ray4477/Senior-design-fit-ml/3D_enclosure/case v1.stl

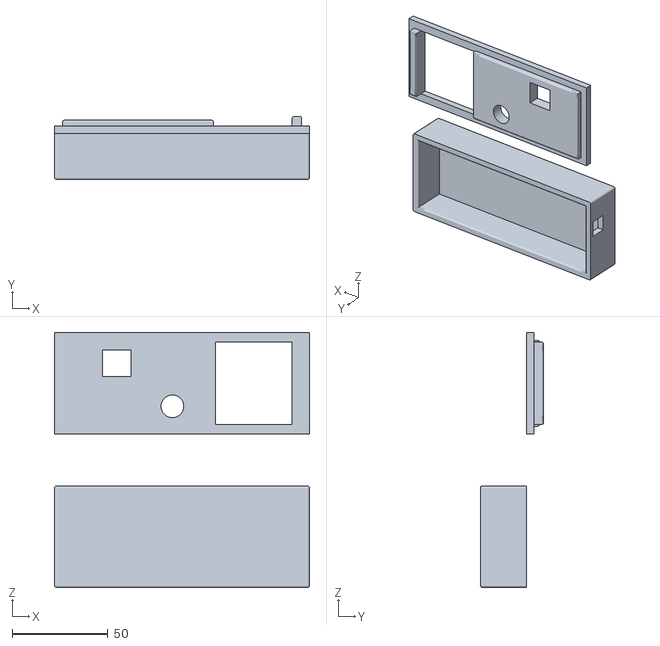
[picture p1: CAD file, 2026-10-25]
3D_enclosure/case v1.stl
133.0 x 33.0 x 133.0
