ray4477/Senior-design-fit-ml/wearable_v1_hw/wearable_som/wearable_som.step

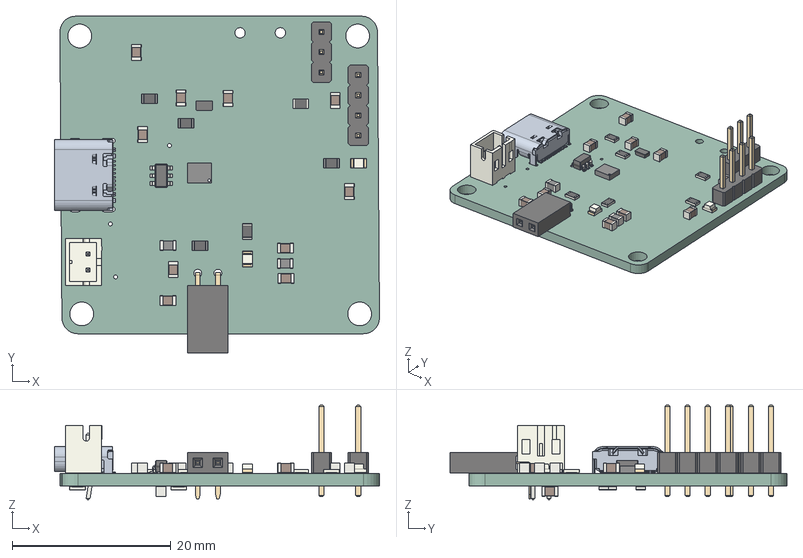
[picture p2: CAD file, 2025-01-29]
wearable_v1_hw/wearable_som/wearable_som.step
40.9 x 42.4 x 11.9 mm
LED_0805_2012Metric x 2
C_0805_2012Metric x 11
R_0805_2012Metric x 9
PinHeader_1x04_P254mm_Vertical
L_0805_2012Metric x 2
PinSocket_1x02_P254mm_Horizontal
USB4105GFA
BMI270
SOT_23_6
JST_B2B_PH_K
MicroCrystal_CC8V_T1A
PinHeader_1x03_P254mm_Vertical
wearable_som_PCB
