ray4477/Senior-design-fit-ml/3D_enclosure/wearable_enclosure.stl

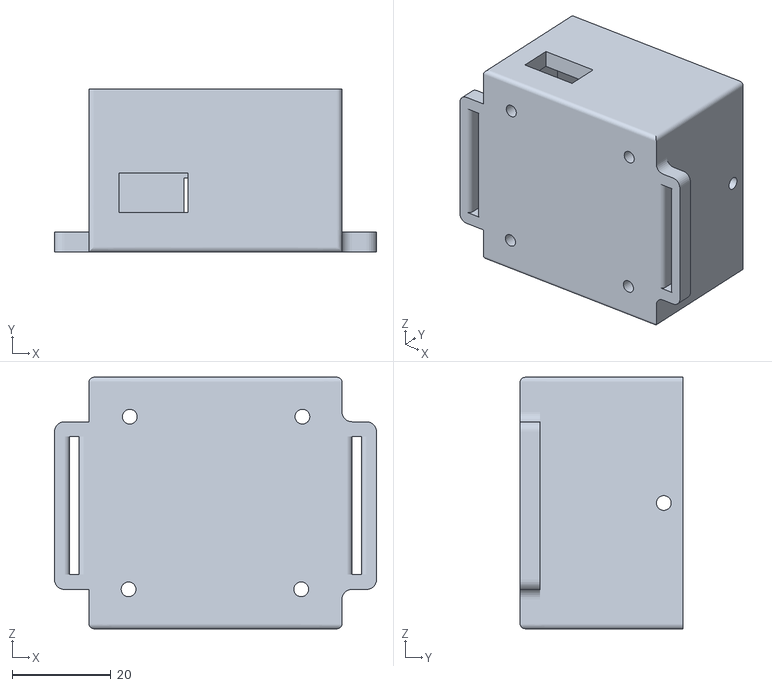
[picture p3: CAD file, 2025-04-21]
3D_enclosure/wearable_enclosure.stl
65.3 x 33.0 x 51.0
