ray4477/Senior-design-fit-ml/(list of files, cad)

Other CAD files:
3D_enclosure/v2_enclosure.stl
