ray4477/Senior-design-fit-ml/custom_nrf_firmware/build/custom_nrf_firmware_sysbuild_cache.txt

APPLICATION_BINARY_DIR:PATH=C:/Users/raymo/Documents/GitHub/Senior-design-fit-ml/custom_nrf_firmware/build
APPLICATION_SOURCE_DIR:PATH=C:/ncs/v2.9.0/zephyr/share/sysbuild/template
APP_DIR:PATH=c:/Users/raymo/Documents/GitHub/Senior-design-fit-ml/custom_nrf_firmware
BOARD_DIR:PATH=C:/Users/raymo/nordic/boards/fitml/nrf52811_wearable
BOARD_DIRECTORIES:INTERNAL=C:/Users/raymo/nordic/boards/fitml/nrf52811_wearable
BOARD_EXTENSIONS:BOOL=ON
BOARD_ROOT:PATH=C:/Users/raymo/nordic;C:/Users/raymo/Documents/GitHub/Senior-design-fit-ml/custom_nrf_firmware
CACHED_BOARD:STRING=nrf52811_wearable/nrf52811
CACHED_SHIELD:STRING=
DTC_OVERLAY_FILE:UNINITIALIZED=app1.overlay
FIND_PACKAGE_MESSAGE_DETAILS_Python3:INTERNAL=[C:/ncs/toolchains/b620d30767/opt/bin/python.exe][cfound components: Interpreter ][v3.12.4(3.8)]
HWM:INTERNAL=v2
HWMv2:INTERNAL=True
NCS_TOOLCHAIN_VERSION:UNINITIALIZED=NONE
WEST:INTERNAL=C:/ncs/toolchains/b620d30767/opt/bin/python.exe;-m;west
WEST_PYTHON:UNINITIALIZED=C:/ncs/toolchains/b620d30767/opt/bin/python.exe
ZEPHYR_BASE:PATH=C:/ncs/v2.9.0/zephyr
ZEPHYR_RUNNER_CONFIG_KERNEL_HEX:STRING=
Zephyr_DIR:PATH=C:/ncs/v2.9.0/zephyr/share/zephyr-package/cmake
_Python3_EXECUTABLE:INTERNAL=C:/ncs/toolchains/b620d30767/opt/bin/python.exe
_Python3_INTERPRETER_PROPERTIES:INTERNAL=Python;3;12;4;64;;cp312-win_amd64;C:\ncs\toolchains\b620d30767\opt\bin\Lib;C:\ncs\toolchains\b620d30767\opt\bin\Lib;C:\ncs\toolchains\b620d30767\opt\bin\Lib\site-packages;C:\ncs\toolchains\b620d30767\opt\bin\Lib\site-packages
_Python3_INTERPRETER_SIGNATURE:INTERNAL=0a1002e3f1b20f4aea9787ab1144025a
custom_nrf_firmware_NCS_RUNNER_HEX:INTERNAL=C:/Users/raymo/Documents/GitHub/Senior-design-fit-ml/custom_nrf_firmware/build/merged.hex
sysbuild_BINARY_DIR:STATIC=C:/Users/raymo/Documents/GitHub/Senior-design-fit-ml/custom_nrf_firmware/build/_sysbuild
sysbuild_IS_TOP_LEVEL:STATIC=OFF
sysbuild_SOURCE_DIR:STATIC=C:/ncs/v2.9.0/zephyr/share/sysbuild/template
sysbuild_toplevel_BINARY_DIR:STATIC=C:/Users/raymo/Documents/GitHub/Senior-design-fit-ml/custom_nrf_firmware/build
sysbuild_toplevel_IS_TOP_LEVEL:STATIC=ON
sysbuild_toplevel_SOURCE_DIR:STATIC=C:/ncs/v2.9.0/zephyr/share/sysbuild
BOARD:STRING=nrf52811_wearable/nrf52811
SYSBUILD_NAME:STRING=custom_nrf_firmware
SYSBUILD_MAIN_APP:BOOL=True
