ray4477/Senior-design-fit-ml/nrf_firmware/build/ble_imu_wearable_sysbuild_cache.txt

APPLICATION_BINARY_DIR:PATH=C:/Users/raymo/Documents/GitHub/Senior-design-fit-ml/wearable_v2_nrf_firmware/ble_imu_wearable/build
APPLICATION_SOURCE_DIR:PATH=C:/ncs/v2.9.0/zephyr/share/sysbuild/template
APP_DIR:PATH=c:/Users/raymo/Documents/GitHub/Senior-design-fit-ml/wearable_v2_nrf_firmware/ble_imu_wearable
BOARD_DIR:PATH=C:/ncs/v2.9.0/zephyr/boards/nordic/nrf52840dk
BOARD_DIRECTORIES:INTERNAL=C:/ncs/v2.9.0/zephyr/boards/nordic/nrf52840dk
BOARD_EXTENSIONS:BOOL=ON
CACHED_BOARD:STRING=nrf52840dk/nrf52840
CACHED_SHIELD:STRING=
FIND_PACKAGE_MESSAGE_DETAILS_Python3:INTERNAL=[C:/ncs/toolchains/b620d30767/opt/bin/python.exe][cfound components: Interpreter ][v3.12.4(3.8)]
HWM:INTERNAL=v2
HWMv2:INTERNAL=True
NCS_TOOLCHAIN_VERSION:UNINITIALIZED=NONE
WEST:INTERNAL=C:/ncs/toolchains/b620d30767/opt/bin/python.exe;-m;west
WEST_PYTHON:UNINITIALIZED=C:/ncs/toolchains/b620d30767/opt/bin/python.exe
ZEPHYR_BASE:PATH=C:/ncs/v2.9.0/zephyr
Zephyr_DIR:PATH=C:/ncs/v2.9.0/zephyr/share/zephyr-package/cmake
_Python3_EXECUTABLE:INTERNAL=C:/ncs/toolchains/b620d30767/opt/bin/python.exe
_Python3_INTERPRETER_PROPERTIES:INTERNAL=Python;3;12;4;64;;cp312-win_amd64;C:\ncs\toolchains\b620d30767\opt\bin\Lib;C:\ncs\toolchains\b620d30767\opt\bin\Lib;C:\ncs\toolchains\b620d30767\opt\bin\Lib\site-packages;C:\ncs\toolchains\b620d30767\opt\bin\Lib\site-packages
_Python3_INTERPRETER_SIGNATURE:INTERNAL=0a1002e3f1b20f4aea9787ab1144025a
sysbuild_toplevel_BINARY_DIR:STATIC=C:/Users/raymo/Documents/GitHub/Senior-design-fit-ml/wearable_v2_nrf_firmware/ble_imu_wearable/build
sysbuild_toplevel_IS_TOP_LEVEL:STATIC=ON
sysbuild_toplevel_SOURCE_DIR:STATIC=C:/ncs/v2.9.0/zephyr/share/sysbuild
BOARD:STRING=nrf52840dk/nrf52840
SYSBUILD_NAME:STRING=ble_imu_wearable
SYSBUILD_MAIN_APP:BOOL=True
