ray4477/Senior-design-fit-ml/wearable_v2_nrf/wearable_v2_nrf.kicad_pcb

## KiCad design wearable_v2_nrf/wearable_v2_nrf.kicad_pcb (2025-04-21)

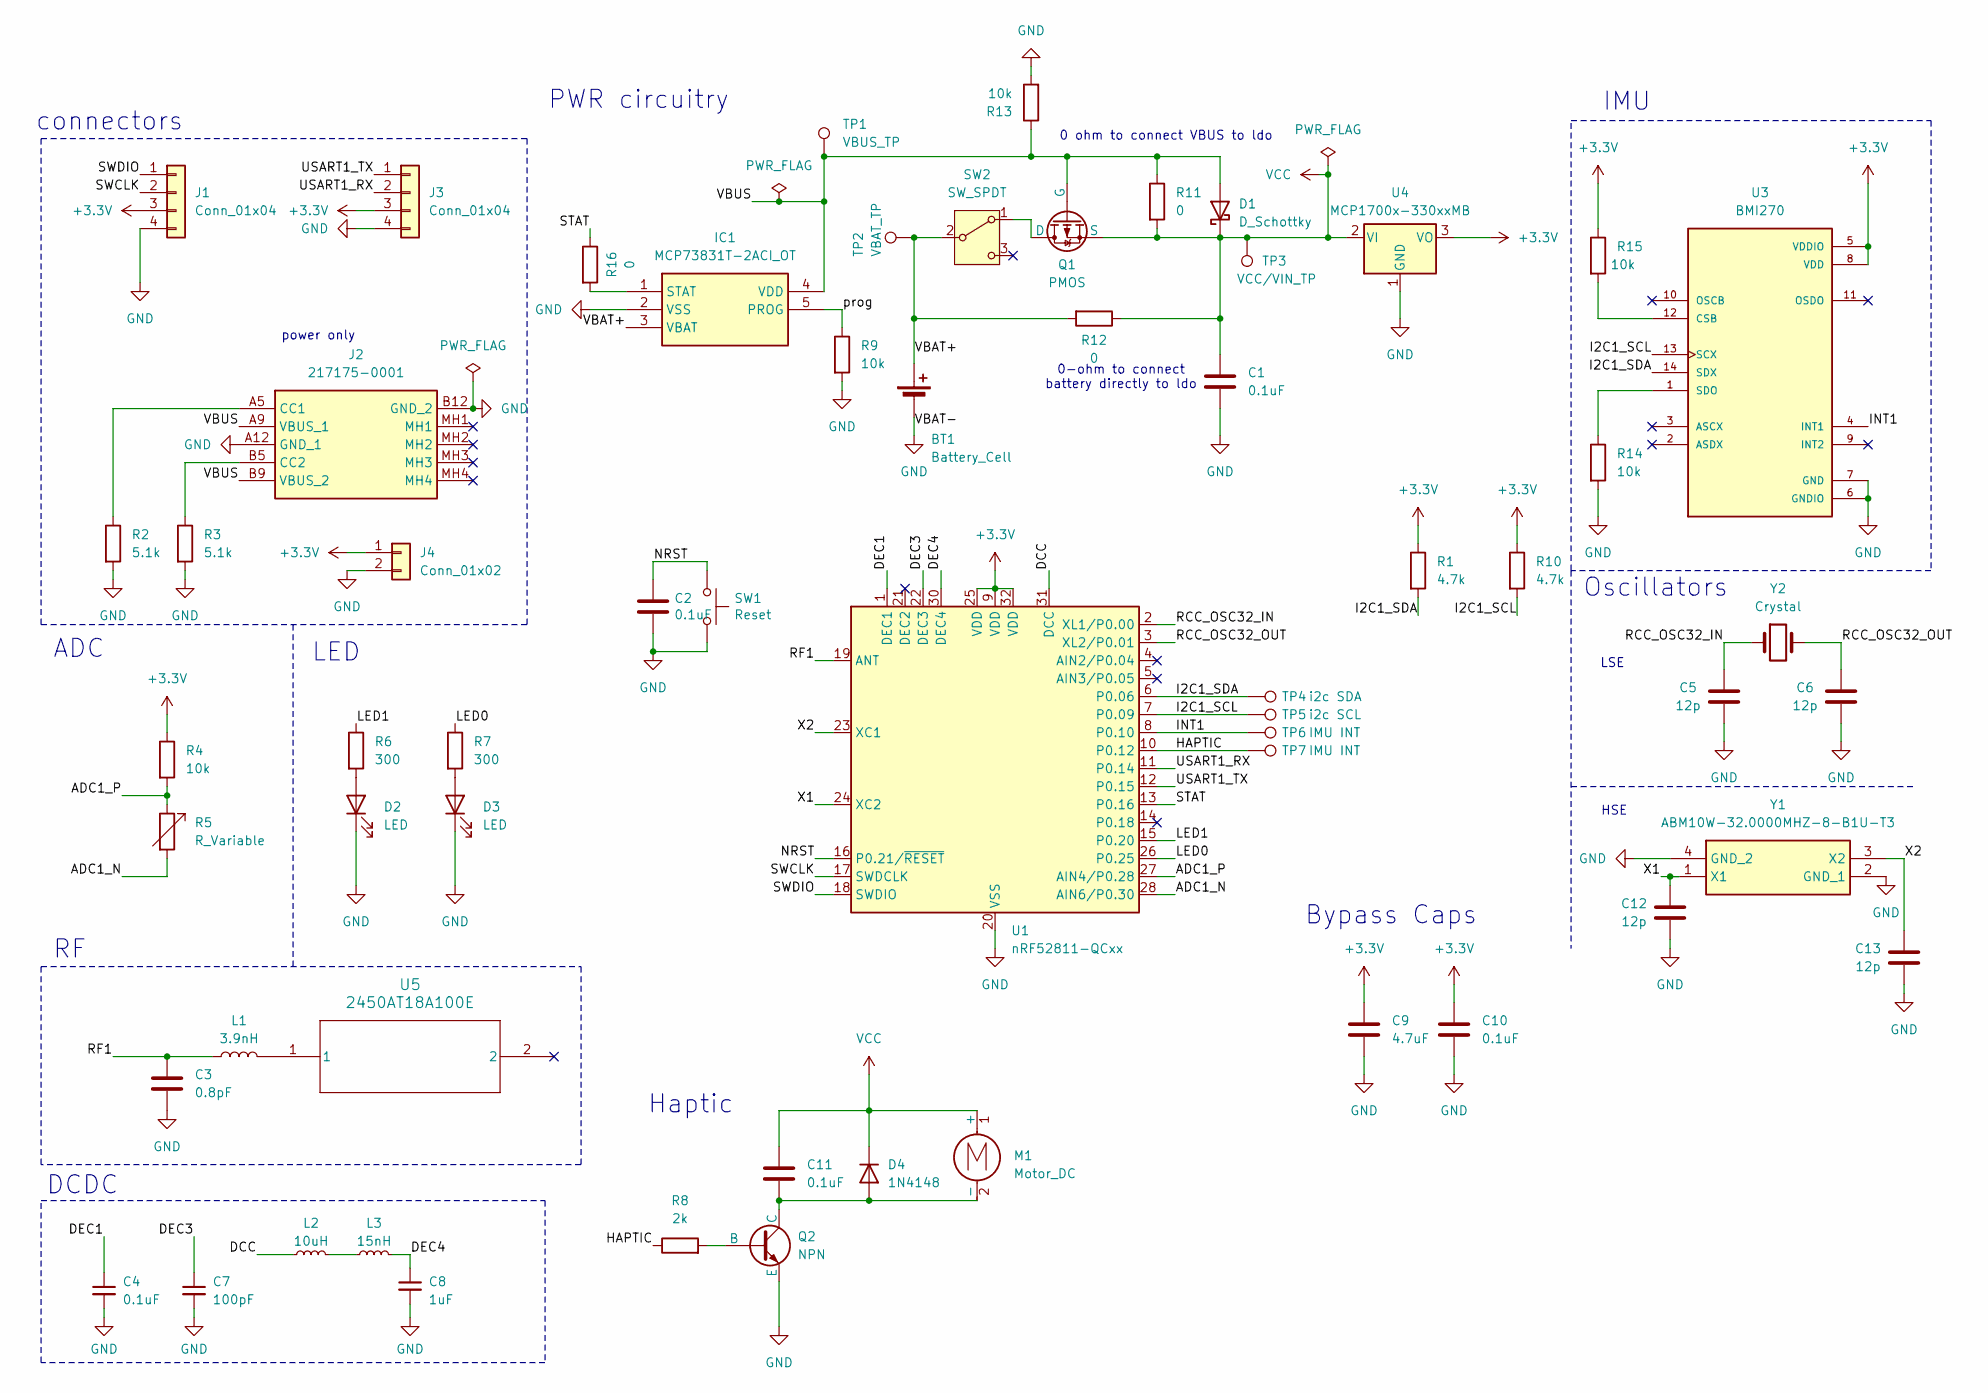
[picture p4: schematic wearable_v2_nrf.kicad_sch]

Parts:
BT1: Battery_Cell; Molex_PicoBlade_53047-0210_1x02_P1.25mm_Vertical
C1, C2, C10, C11: 0.1uF; C_0805_2012Metric
C3: 0.8pF; C_0805_2012Metric
C4: 0.1uF; C_0805_2012Metric; Manufacturer_Part_Number KGM05AR71C104KN
C5, C6, C12, C13: 12p; C_0805_2012Metric
C7: 100pF; C_0805_2012Metric; Manufacturer_Part_Number KGM05ACG1H101JN
C8: 1uF; C_0805_2012Metric; Manufacturer_Part_Number CM05X7R105K06AH-HE
C9: 4.7uF; C_0805_2012Metric
D1: D_Schottky; SOD2513X120N
D2, D3: LED; LED_0805_2012Metric
D4: 1N4148; D_SOD-323_HandSoldering
IC1: MCP73831T-2ACI_OT; SOT-23-5; Mouser Part Number 579-MCP73831T-2ACIOT
J1, J3: Conn_01x04; PinHeader_1x04_P2.54mm_Vertical
J2: 217175-0001; 2171750001; Mouser Part Number 538-217175-0001
J4: Conn_01x02; PinHeader_1x02_P2.54mm_Vertical
L1: 3.9nH; L_0805_2012Metric
L2: 10uH; L_0805_2012Metric; Manufacturer_Part_Number KLZ1608MHR100WTD25
L3: 15nH; L_0805_2012Metric; Manufacturer_Part_Number LQG15WZ15NG02D
M1: Motor_DC; PinHeader_1x02_P2.54mm_Vertical
Q1: PMOS; SOT96P240X110-3N
Q2: NPN; SOT95P240X115-3N
R1, R10: 4.7k; R_0805_2012Metric
R2, R3: 5.1k; R_0805_2012Metric
R4, R9, R13, R14, R15: 10k; R_0805_2012Metric
R5: R_Variable; PinHeader_1x02_P2.54mm_Vertical
R6, R7: 300; R_0805_2012Metric
R8: 2k; R_0805_2012Metric
R11, R12, R16: 0; R_0805_2012Metric
SW1: Reset; SW_SPST_B3SL-1002P
SW2: SW_SPDT; PinHeader_1x03_P2.54mm_Vertical
TP1: VBUS_TP; TestPoint_THTPad_1.0x1.0mm_Drill0.5mm
TP2: VBAT_TP; TestPoint_THTPad_1.0x1.0mm_Drill0.5mm
TP3: VCC/VIN_TP; TestPoint_THTPad_1.0x1.0mm_Drill0.5mm
TP4: i2c SDA; TestPoint_THTPad_1.5x1.5mm_Drill0.7mm
TP5: i2c SCL; TestPoint_THTPad_1.5x1.5mm_Drill0.7mm
TP6, TP7: IMU INT; TestPoint_THTPad_1.5x1.5mm_Drill0.7mm
U1: nRF52811-QCxx; QFN-32-1EP_5x5mm_P0.5mm_EP3.6x3.6mm_ThermalVias
U3: BMI270; XDCR_BMI270
U4: MCP1700x-330xxMB; SOT-89-3
U5: 2450AT18A100E; 2450AT18A100E_JOT
Y1: ABM10W-32.0000MHZ-8-B1U-T3; ABM10W240000MHZ8K1ZT3; Mouser Part Number 815-10W32-8B1UT
Y2: Crystal; Crystal_SMD_MicroCrystal_CC8V-T1A-2Pin_2.0x1.2mm

Connections:
+3.3V: C9.1, C10.1, J1.3, J3.3, J4.1, R1.1, R4.1, R10.1, R15.1, U1.9 (VDD), U1.25 (VDD), U1.32 (VDD), U3.5 (VDDIO), U3.8 (VDD), U4.3 (VO)
/ADC1_N: R5.2, U1.28 (AIN6/P0.30)
/ADC1_P: R4.2, R5.1, U1.27 (AIN4/P0.28)
/DCC: L2.1, U1.31 (DCC)
/DEC1: C4.1, U1.1 (DEC1)
/DEC3: C7.1, U1.22 (DEC3)
/DEC4: C8.1, L3.2, U1.30 (DEC4)
/HAPTIC: R8.1, TP7.1, U1.10 (P0.12)
/I2C1_SCL: R10.2, TP5.1, U1.7 (P0.09), U3.13 (SCX)
/I2C1_SDA: R1.2, TP4.1, U1.6 (P0.06), U3.14 (SDX)
/INT1: TP6.1, U1.8 (P0.10), U3.4 (INT1)
/LED0: R7.1, U1.26 (P0.25)
/LED1: R6.1, U1.15 (P0.20)
/NRST: C2.1, SW1.1, U1.16 (P0.21/~RESET)
/RCC_OSC32_IN: C5.2, U1.2 (XL1/P0.00), Y2.1
/RCC_OSC32_OUT: C6.2, U1.3 (XL2/P0.01), Y2.2
/RF1: C3.1, L1.1, U1.19 (ANT)
/STAT: R16.1, U1.13 (P0.16)
/SWCLK: J1.2, U1.17 (SWDCLK)
/SWDIO: J1.1, U1.18 (SWDIO)
/USART1_RX: J3.2, U1.11 (P0.14)
/USART1_TX: J3.1, U1.12 (P0.15)
/VBAT+: BT1.1 (+), IC1.3 (VBAT), R12.2, SW2.2 (B), TP2.1
/VBUS: D1.2 (A), IC1.4 (VDD), J2.A9 (VBUS_1), J2.B9 (VBUS_2), Q1.1 (G), R11.1, R13.1, TP1.1
/X1: C12.2, U1.24 (XC2), Y1.1 (X1)
/X2: C13.2, U1.23 (XC1), Y1.3 (X2)
/prog: IC1.5 (PROG), R9.1
GND: BT1.2 (-), C1.2, C2.2, C3.2, C4.2, C5.1, C6.1, C7.2, C8.2, C9.2, C10.2, C12.1, C13.1, D2.1 (K), D3.1 (K), IC1.2 (VSS), J1.4, J2.A12 (GND_1), J2.B12 (GND_2), J3.4, J4.2, Q2.2 (E), R2.2, R3.2, R9.2, R13.2, R14.2, SW1.2, U1.20 (VSS), U1.29 (VSS), U1.33 (VSS), U3.6 (GNDIO), U3.7 (GND), U4.1 (GND), Y1.2 (GND_1), Y1.4 (GND_2)
unnamed: D2.2 (A), R6.2
unnamed: D3.2 (A), R7.2
unnamed: C11.2, D4.2 (A), M1.2 (-), Q2.3 (C)
unnamed: IC1.1 (STAT), R16.2
unnamed: J2.A5 (CC1), R2.1
unnamed: J2.B5 (CC2), R3.1
unnamed: L1.2, U5.1
unnamed: L2.2, L3.1
unnamed: Q1.3 (D), SW2.1 (A)
unnamed: Q2.1 (B), R8.2
unnamed: R15.2, U3.12 (CSB)
unnamed: R14.1, U3.1 (SDO)
VCC: C1.1, C11.1, D1.1 (K), D4.1 (K), M1.1 (+), Q1.2 (S), R11.2, R12.1, TP3.1, U4.2 (VI)

Notes on the sheet:
0 ohm to connect VBUS to ldo
power only
PWR circuitry
IMU
Bypass Caps
LSE
LED
ADC
DCDC
connectors
HSE
0-ohm to connect battery directly to ldo
Oscillators
Haptic

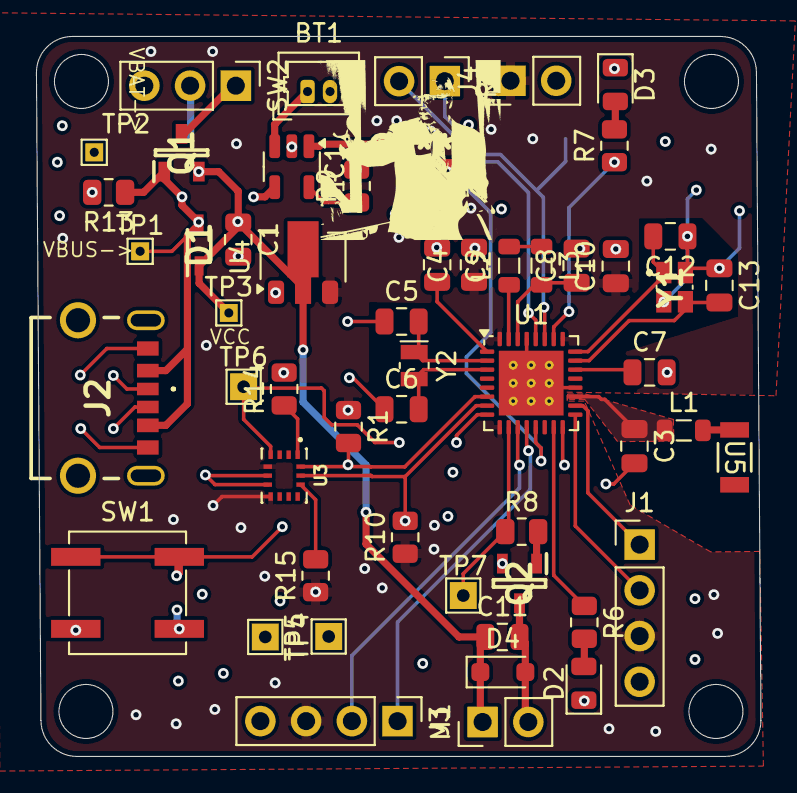
[picture p5: board wearable_v2_nrf.kicad_pcb from above]

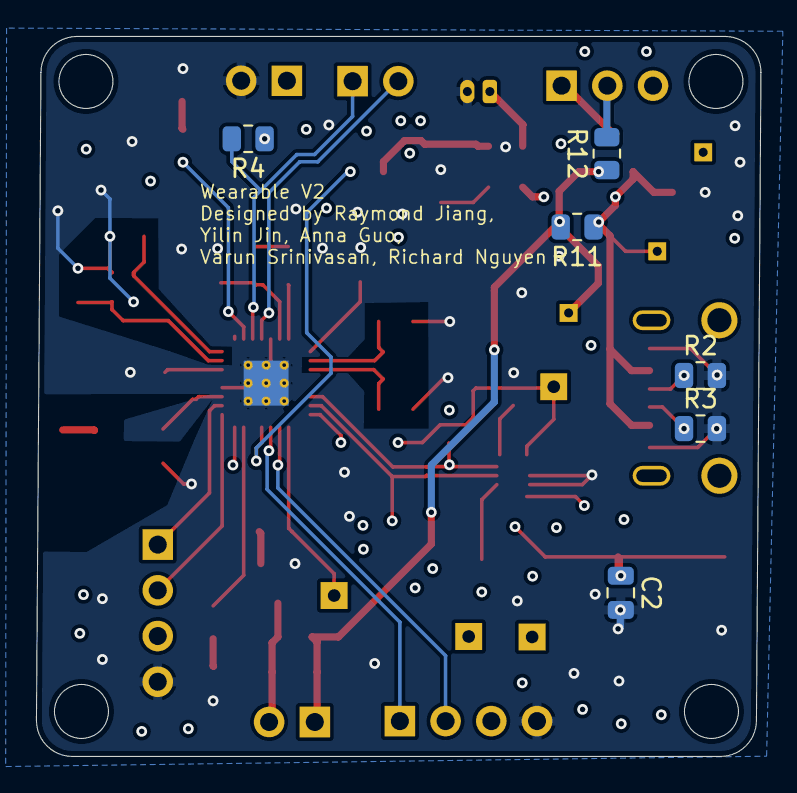
[picture p6: board wearable_v2_nrf.kicad_pcb from below]

Board: 4 copper layers, 40.2 x 40.0 mm, 60 parts (6 on the bottom side), 41 nets.
