ray4477/Senior-design-fit-ml/wearable_v1_hw/wearables_v2/wearables_v2.kicad_pcb

## KiCad design wearable_v1_hw/wearables_v2/wearables_v2.kicad_pcb (2025-02-10)

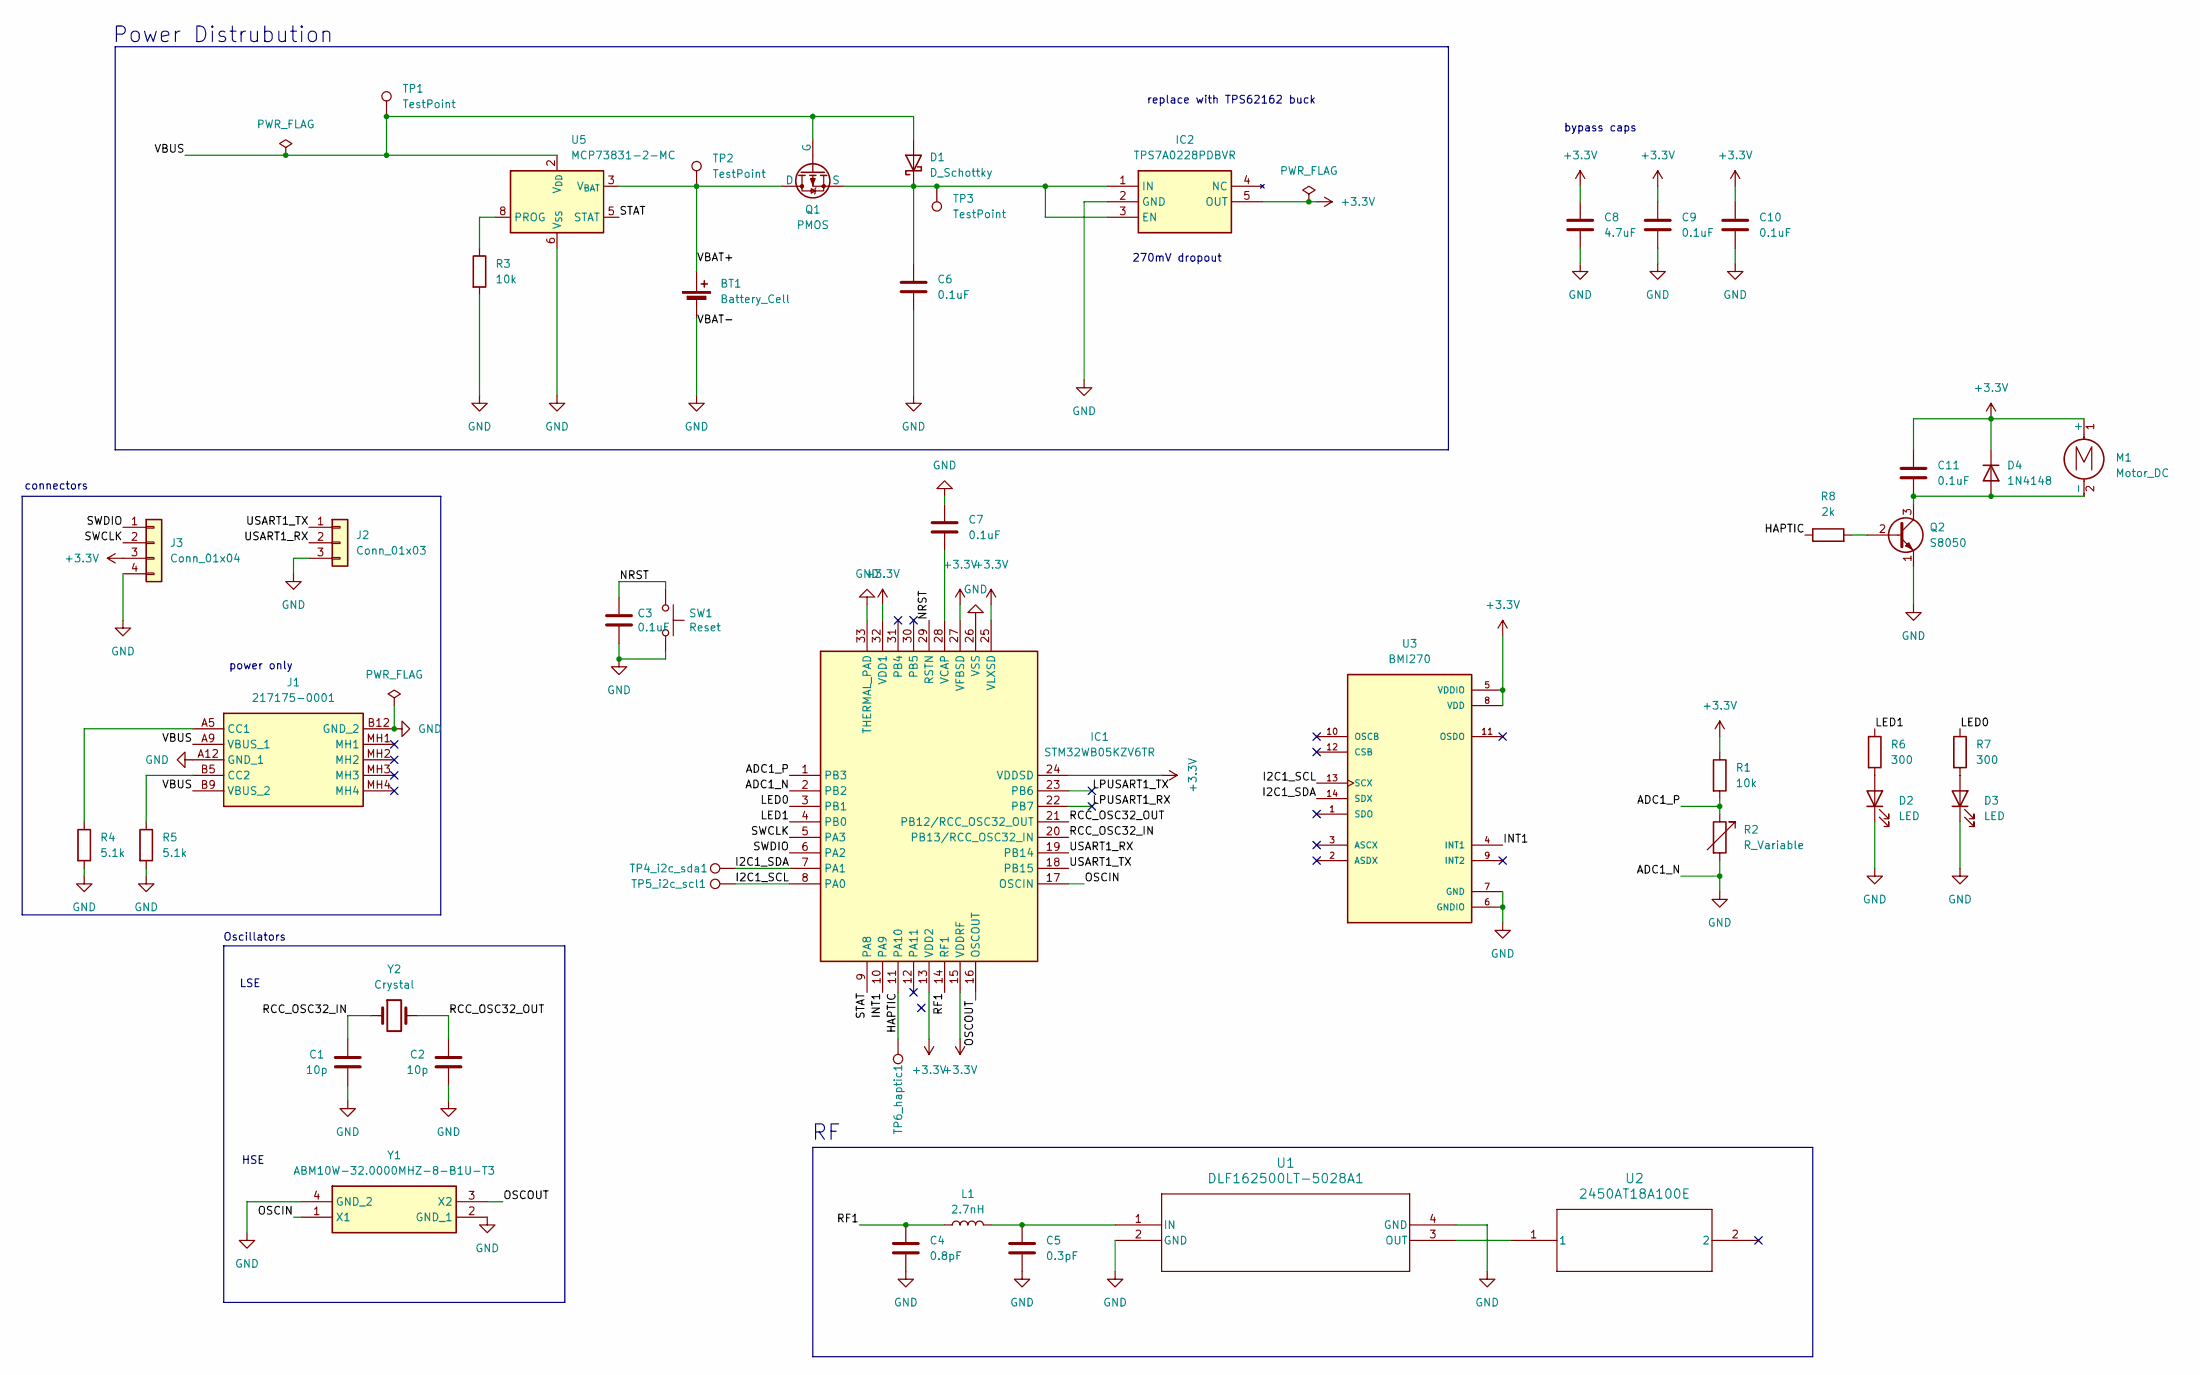
[picture p7: schematic wearables_v2.kicad_sch]

Parts:
BT1: Battery_Cell; JST_PH_B2B-PH-K_1x02_P2.00mm_Vertical
C1, C2: 10p; C_0805_2012Metric
C3, C6, C7, C9, C10, C11: 0.1uF; C_0805_2012Metric
C4: 0.8pF; C_0805_2012Metric
C5: 0.3pF; C_0805_2012Metric
C8: 4.7uF; C_0805_2012Metric
D1: D_Schottky; SOD2513X120N
D2, D3: LED; LED_0805_2012Metric
D4: 1N4148; D_DO-35_SOD27_P7.62mm_Horizontal
IC1: STM32WB05KZV6TR; QFN50P500X500X100-33N-D; Mouser Part Number 511-STM32WB05KNV6TR
IC2: TPS7A0228PDBVR; SOT95P280X145-5N; Mouser Part Number 595-TPS7A0228PDBVR
J1: 217175-0001; 2171750001; Mouser Part Number 538-217175-0001
J2: Conn_01x03; PinHeader_1x03_P2.54mm_Vertical
J3: Conn_01x04; PinHeader_1x04_P2.54mm_Vertical
L1: 2.7nH; L_0805_2012Metric
M1: Motor_DC; PinHeader_1x02_P2.54mm_Vertical
Q1: PMOS; SOT96P240X110-3N
Q2: S8050; TO-92_Inline
R1, R3: 10k; R_0805_2012Metric
R2: R_Variable; PinSocket_1x02_P2.54mm_Horizontal
R4, R5: 5.1k; R_0805_2012Metric
R6, R7: 300; R_0805_2012Metric
R8: 2k; R_0805_2012Metric
SW1: Reset; SW_SPST_B3SL-1002P
TP1, TP2, TP3: TestPoint; TestPoint_THTPad_1.0x1.0mm_Drill0.5mm
TP4_i2c_sda1, TP5_i2c_scl1, TP6_haptic1: TestPoint; 5000
U1: DLF162500LT-5028A1; DLF-4_1P6X0P8
U2: 2450AT18A100E; 2450AT18A100E_JOT
U3: BMI270; XDCR_BMI270
U5: MCP73831-2-MC; DFN-8-1EP_3x2mm_P0.5mm_EP1.7x1.4mm
Y1: ABM10W-32.0000MHZ-8-B1U-T3; ABM10W240000MHZ8K1ZT3; Mouser Part Number 815-10W32-8B1UT
Y2: Crystal; Crystal_SMD_MicroCrystal_CC8V-T1A-2Pin_2.0x1.2mm

Connections:
+3.3V: C8.1, C9.1, C10.1, C11.1, D4.1 (K), IC1.13 (VDD2), IC1.15 (VDDRF), IC1.24 (VDDSD), IC1.25 (VLXSD), IC1.27 (VFBSD), IC1.32 (VDD1), IC2.5 (OUT), J3.3, M1.1 (+), R1.1, U3.5 (VDDIO), U3.8 (VDD)
/ADC1_P: IC1.1 (PB3), R1.2, R2.1
/HAPTIC: IC1.11 (PA10), R8.1, TP6_haptic1.1
/I2C1_SCL: IC1.8 (PA0), TP5_i2c_scl1.1, U3.13 (SCX)
/I2C1_SDA: IC1.7 (PA1), TP4_i2c_sda1.1, U3.14 (SDX)
/INT1: IC1.10 (PA9), U3.4 (INT1)
/LED0: IC1.3 (PB1), R7.1
/LED1: IC1.4 (PB0), R6.1
/LPUSART1_RX: IC1.22 (PB7)
/LPUSART1_TX: IC1.23 (PB6)
/NRST: C3.1, IC1.29 (RSTN), SW1.1
/OSCIN: IC1.17 (OSCIN), Y1.1 (X1)
/OSCOUT: IC1.16 (OSCOUT), Y1.3 (X2)
/RCC_OSC32_IN: C1.2, IC1.20 (PB13/RCC_OSC32_IN), Y2.1
/RCC_OSC32_OUT: C2.2, IC1.21 (PB12/RCC_OSC32_OUT), Y2.2
/RF1: C4.1, IC1.14 (RF1), L1.1
/STAT: IC1.9 (PA8), U5.5 (STAT)
/SWCLK: IC1.5 (PA3), J3.2
/SWDIO: IC1.6 (PA2), J3.1
/USART1_RX: IC1.19 (PB14), J2.2
/USART1_TX: IC1.18 (PB15), J2.1
/VBAT+: BT1.1 (+), Q1.1 (D), TP2.1, U5.3 (V_{BAT}), U5.4 (V_{BAT})
/VBUS: D1.2 (A), J1.A9 (VBUS_1), J1.B9 (VBUS_2), Q1.2 (G), TP1.1, U5.1 (V_{DD}), U5.2 (V_{DD})
GND: BT1.2 (-), C1.1, C2.1, C3.2, C4.2, C5.2, C6.2, C7.1, C8.2, C9.2, C10.2, D2.1 (K), D3.1 (K), IC1.2 (PB2), IC1.26 (VSS), IC1.33 (THERMAL_PAD), IC2.2 (GND), J1.A12 (GND_1), J1.B12 (GND_2), J2.3, J3.4, Q2.1 (E), R2.2, R3.2, R4.2, R5.2, SW1.2, U1.2 (GND), U1.4 (GND), U3.6 (GNDIO), U3.7 (GND), U5.6 (V_{SS}), Y1.2 (GND_1), Y1.4 (GND_2); also elsewhere on the board
unnamed 24: C6.1, D1.1 (K), IC2.1 (IN), IC2.3 (EN), Q1.3 (S), TP3.1; also elsewhere on the board
unnamed: D2.2 (A), R6.2
unnamed: D3.2 (A), R7.2
unnamed: C11.2, D4.2 (A), M1.2 (-), Q2.3 (C)
unnamed: C7.2, IC1.28 (VCAP)
unnamed: J1.A5 (CC1), R4.1
unnamed: J1.B5 (CC2), R5.1
unnamed: Q2.2 (B), R8.2
unnamed: C5.1, L1.2, U1.1 (IN)
unnamed: U1.3 (OUT), U2.1
unnamed: R3.1, U5.8 (PROG)

Notes on the sheet:
270mV dropout
HSE
Oscillators
replace with TPS62162 buck
connectors
LSE
Power Distrubution
bypass caps
power only

Board: 2 copper layers, 47 parts (0 on the bottom side), 33 nets, no tracks yet.

Other parts of the board:
SW2: SW_Nidec_CAS-120A1; Nidec_Copal_CAS-120A

Their connections:
GND: SW2.3 (A); also elsewhere on the board
unnamed 24: SW2.1 (C); also elsewhere on the board
