ray4477/Senior-design-fit-ml/wearable_v1_hw/wearable_som/wearable_som.kicad_pcb

## KiCad design wearable_v1_hw/wearable_som/wearable_som.kicad_pcb (2025-01-29)

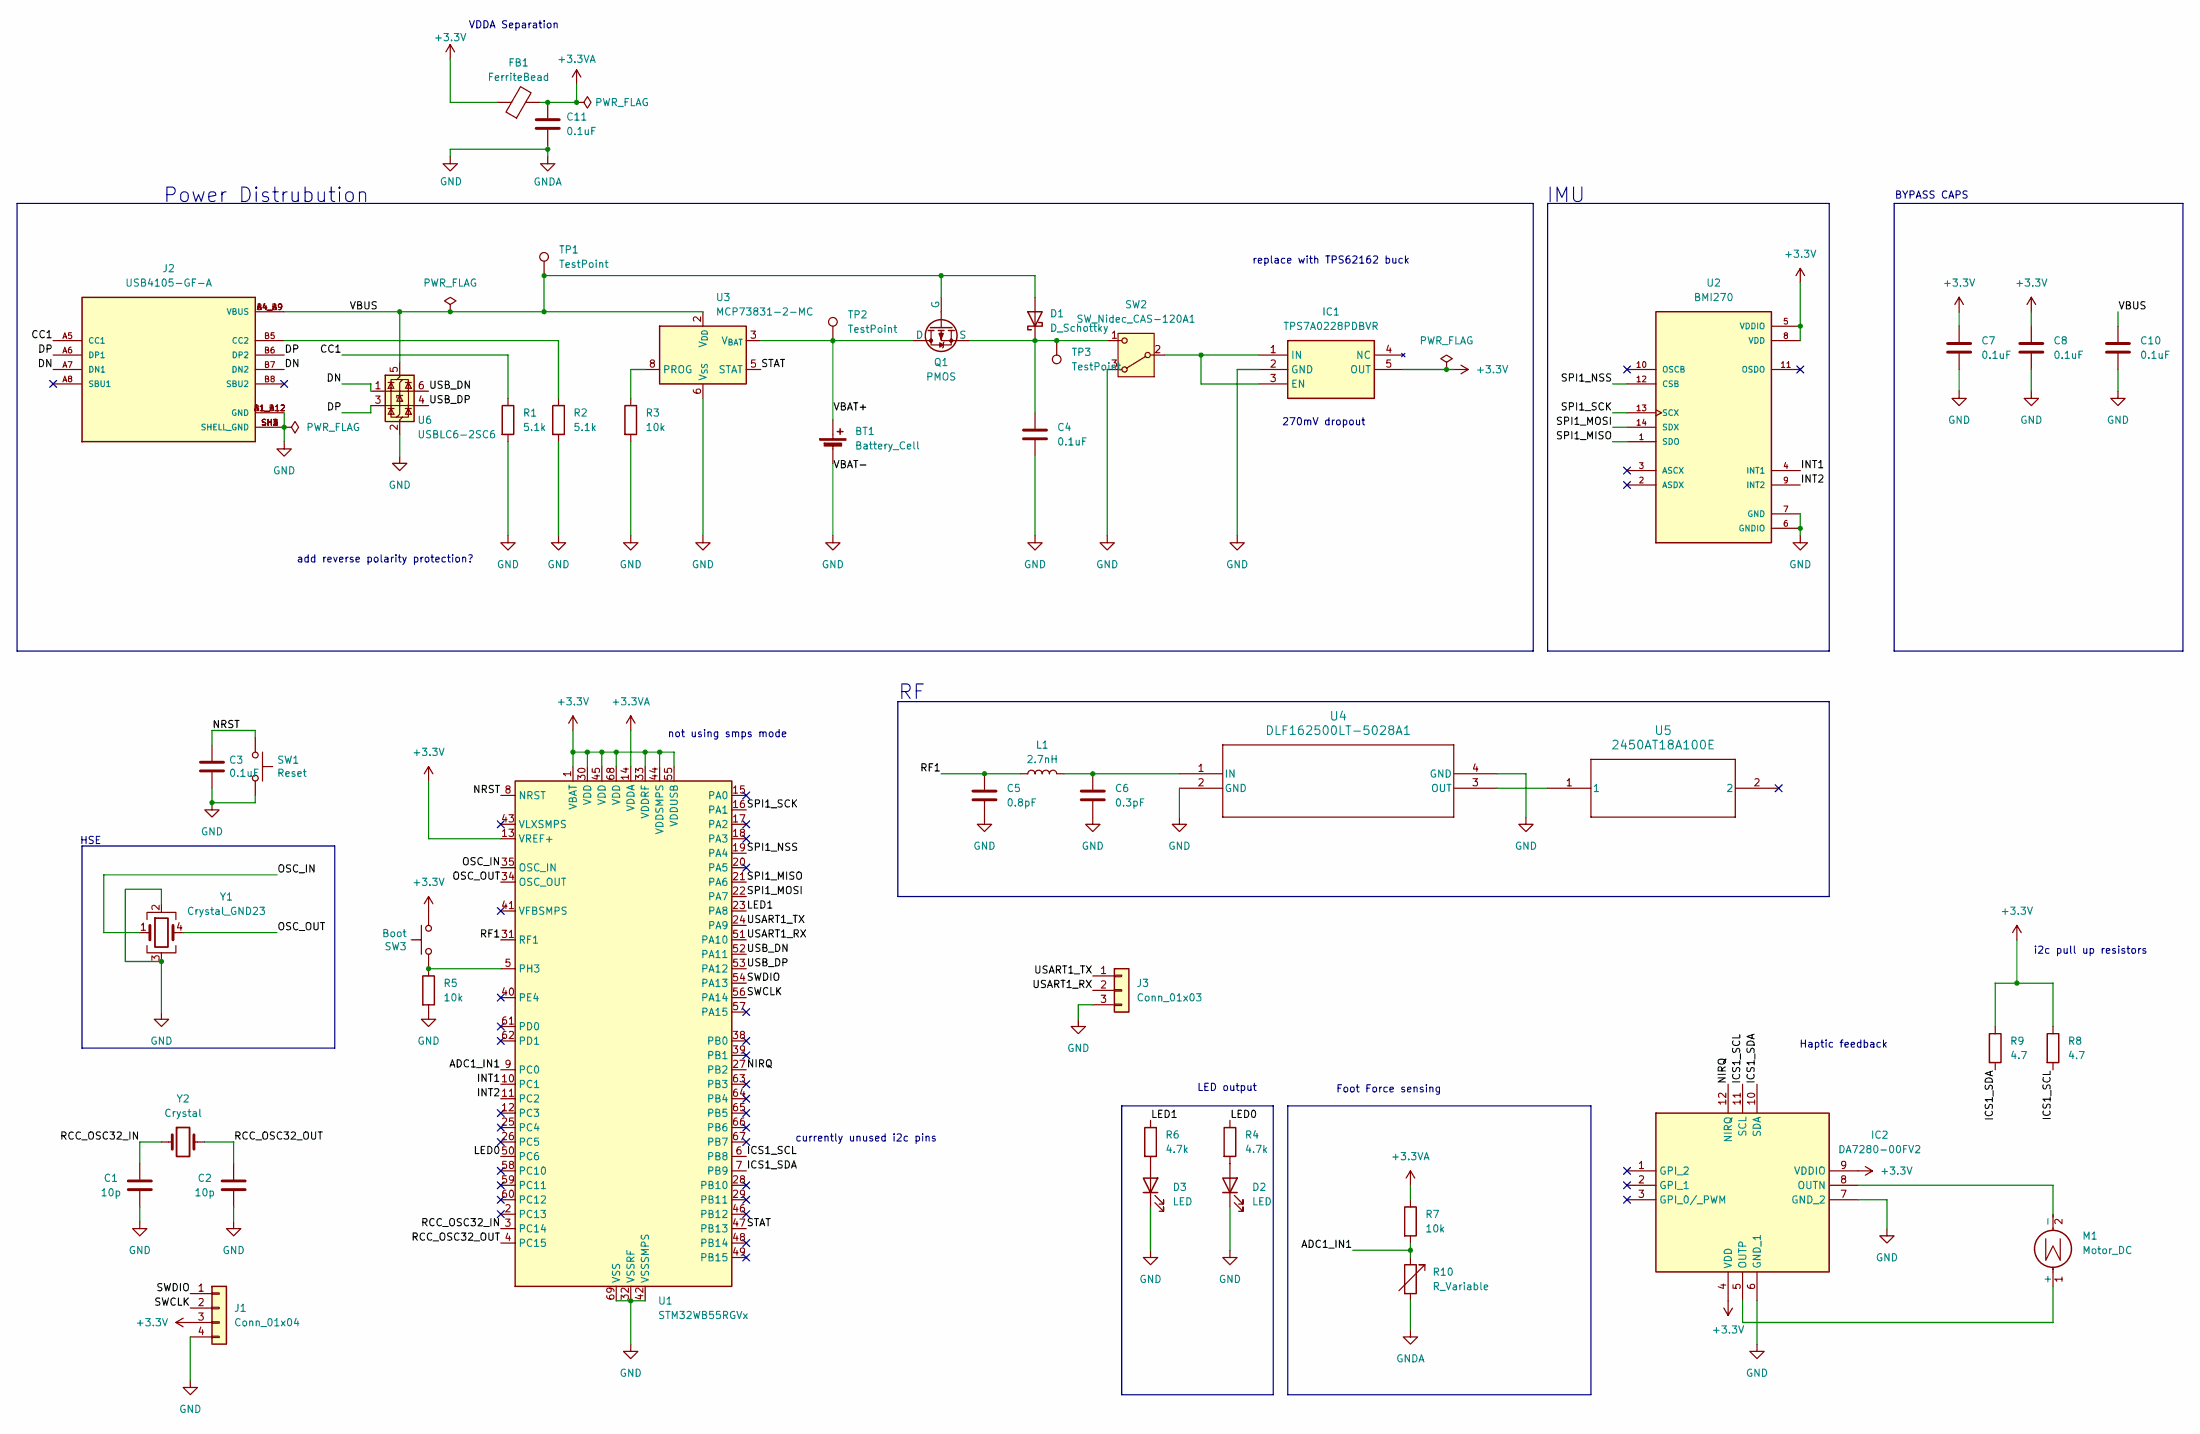
[picture p8: schematic wearable_som.kicad_sch]

Parts:
BT1: Battery_Cell; JST_PH_B2B-PH-K_1x02_P2.00mm_Vertical
C1, C2: 10p; C_0805_2012Metric
C3, C4, C7, C8, C10: 0.1uF; C_0805_2012Metric
C5: 0.8pF; C_0805_2012Metric
C6: 0.3pF; C_0805_2012Metric
C11: 0.1uF; C_0805_2012Metric; Mouser Part Number 80-C0805C104M5R
D1: D_Schottky; SOD2513X120N
D2, D3: LED; LED_0805_2012Metric
FB1: FerriteBead; L_0805_2012Metric; Mouser Part Number 704-MFBW1V2012-121-R
IC1: TPS7A0228PDBVR; SOT95P280X145-5N; Mouser Part Number 595-TPS7A0228PDBVR
IC2: DA7280-00FV2; QFN65P300X300X84-12N; Manufacturer_Part_Number DA7280-00FV2
J1: Conn_01x04; PinHeader_1x04_P2.54mm_Vertical
J2: USB4105-GF-A; GCT_USB4105-GF-A; PARTREV B4
J3: Conn_01x03; PinHeader_1x03_P2.54mm_Vertical
L1: 2.7nH; L_0805_2012Metric
M1: Motor_DC; TestPoint_2Pads_Pitch5.08mm_Drill1.3mm
Q1: PMOS; SOT96P240X110-3N
R1, R2: 5.1k; R_0805_2012Metric
R3, R5, R7: 10k; R_0805_2012Metric
R4, R6: 4.7k; R_0805_2012Metric
R8, R9: 4.7; R_0805_2012Metric
R10: R_Variable; PinSocket_1x02_P2.54mm_Horizontal
SW1: Reset; SW_SPST_B3SL-1002P
SW2: SW_Nidec_CAS-120A1; Nidec_Copal_CAS-120A
SW3: Boot; SW_SPST_B3SL-1002P
TP1, TP2, TP3: TestPoint; TestPoint_THTPad_1.0x1.0mm_Drill0.5mm
U1: STM32WB55RGVx; QFN-68-1EP_8x8mm_P0.4mm_EP6.4x6.4mm
U2: BMI270; XDCR_BMI270
U3: MCP73831-2-MC; DFN-8-1EP_3x2mm_P0.5mm_EP1.7x1.4mm
U4: DLF162500LT-5028A1; DLF-4_1P6X0P8
U5: 2450AT18A100E; 2450AT18A100E_JOT
U6: USBLC6-2SC6; SOT-23-6
Y1: Crystal_GND23; Crystal_SMD_2016-4Pin_2.0x1.6mm
Y2: Crystal; Crystal_SMD_MicroCrystal_CC8V-T1A-2Pin_2.0x1.2mm

Connections:
+3.3V: C7.1, C8.1, FB1.1, IC1.5 (OUT), IC2.4 (VDD), IC2.9 (VDDIO), J1.3, R8.1, R9.1, SW3.2, U1.1 (VBAT), U1.13 (VREF+), U1.30 (VDD), U1.33 (VDDRF), U1.44 (VDDSMPS), U1.45 (VDD), U1.55 (VDDUSB), U1.68 (VDD), U2.5 (VDDIO), U2.8 (VDD); also elsewhere on the board
+3.3VA: C11.1, FB1.2, R7.1, U1.14 (VDDA)
/ADC1_IN1: R7.2, R10.1, U1.9 (PC0)
/CC1: J2.A5 (CC1), R1.1
/DN: J2.A7 (DN1), J2.B7 (DN2), U6.1 (I/O1)
/DP: J2.A6 (DP1), J2.B6 (DP2), U6.3 (I/O2)
/ICS1_SCL: IC2.11 (SCL), R8.2, U1.6 (PB8)
/ICS1_SDA: IC2.10 (SDA), R9.2, U1.7 (PB9)
/INT1: U1.10 (PC1), U2.4 (INT1)
/INT2: U1.11 (PC2), U2.9 (INT2)
/LED0: R4.1, U1.50 (PC6)
/LED1: R6.1, U1.23 (PA8)
/NIRQ: IC2.12 (NIRQ), U1.27 (PB2)
/NRST: C3.1, SW1.1, U1.8 (NRST)
/OSC_IN: U1.35 (OSC_IN), Y1.1
/OSC_OUT: U1.34 (OSC_OUT), Y1.4
/RCC_OSC32_IN: C1.2, U1.3 (PC14), Y2.1
/RCC_OSC32_OUT: C2.2, U1.4 (PC15), Y2.2
/RF1: C5.1, L1.1, U1.31 (RF1)
/SPI1_MISO: U1.21 (PA6), U2.1 (SDO)
/SPI1_MOSI: U1.22 (PA7), U2.14 (SDX)
/SPI1_NSS: U1.19 (PA4), U2.12 (CSB)
/SPI1_SCK: U1.16 (PA1), U2.13 (SCX)
/STAT: U1.47 (PB13), U3.5 (STAT)
/SWCLK: J1.2, U1.56 (PA14)
/SWDIO: J1.1, U1.54 (PA13)
/USART1_RX: J3.2, U1.51 (PA10)
/USART1_TX: J3.1, U1.24 (PA9)
/USB_DN: U1.52 (PA11), U6.6 (I/O1)
/USB_DP: U1.53 (PA12), U6.4 (I/O2)
/VBAT+: BT1.1 (+), Q1.1 (D), TP2.1, U3.3 (V_{BAT}), U3.4 (V_{BAT})
/VBUS: C10.1, D1.2 (A), J2.A4_B9 (VBUS), J2.B4_A9 (VBUS), Q1.2 (G), TP1.1, U3.1 (V_{DD}), U3.2 (V_{DD}), U6.5 (VBUS)
GND: BT1.2 (-), C1.1, C2.1, C3.2, C4.2, C5.2, C6.2, C7.2, C8.2, C10.2, C11.2, D2.1 (K), D3.1 (K), IC1.2 (GND), IC2.6 (GND_1), IC2.7 (GND_2), J1.4, J2.A1_B12 (GND), J2.B1_A12 (GND), J2.SH1 (SHELL_GND), J2.SH2 (SHELL_GND), J2.SH3 (SHELL_GND), J2.SH4 (SHELL_GND), J3.3, R1.2, R2.2, R3.2, R5.2, R10.2, SW1.2, SW2.3 (A), U1.32 (VSSRF), U1.42 (VSSSMPS), U1.69 (VSS), U2.6 (GNDIO), U2.7 (GND), U3.6 (V_{SS}), U4.2 (GND), U4.4 (GND), U6.2 (GND), Y1.2, Y1.3; also elsewhere on the board
unnamed: C4.1, D1.1 (K), Q1.3 (S), SW2.1 (C), TP3.1
unnamed: D2.2 (A), R4.2
unnamed: D3.2 (A), R6.2
unnamed: IC1.1 (IN), IC1.3 (EN), SW2.2 (B)
unnamed: IC2.8 (OUTN), M1.2 (-)
unnamed: IC2.5 (OUTP), M1.1 (+)
unnamed: J2.B5 (CC2), R2.1
unnamed: R5.1, SW3.1, U1.5 (PH3)
unnamed: R3.1, U3.8 (PROG)
unnamed: C6.1, L1.2, U4.1 (IN)
unnamed: U4.3 (OUT), U5.1

Notes on the sheet:
replace with TPS62162 buck
IMU
VDDA Separation
HSE
LED output
i2c pull up resistors
not using smps mode
Haptic feedback
Power Distrubution
BYPASS CAPS
currently unused i2c pins
270mV dropout
Foot Force sensing
add reverse polarity protection?

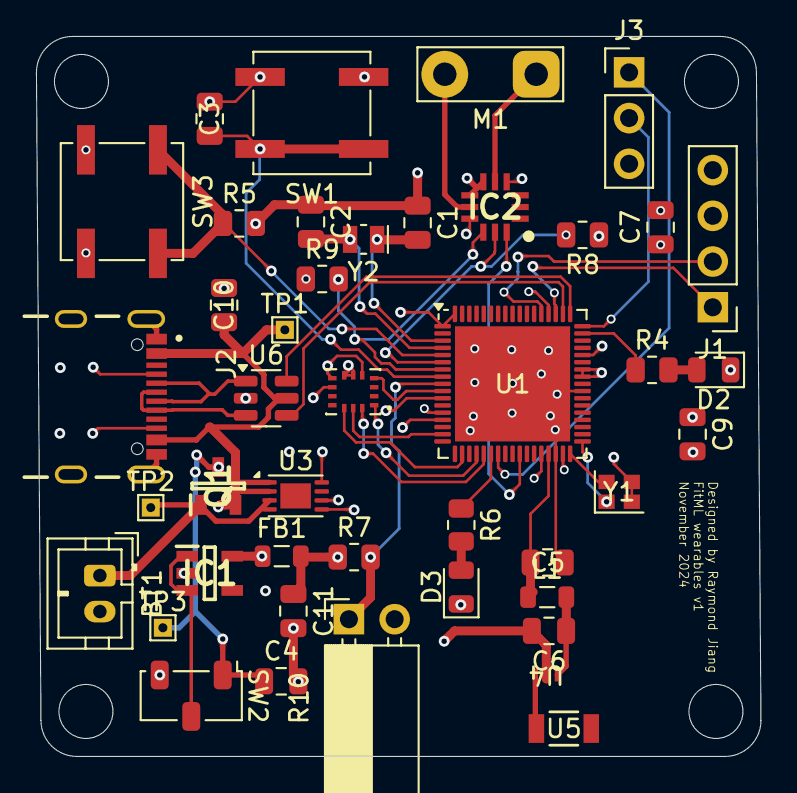
[picture p9: board wearable_som.kicad_pcb from above]

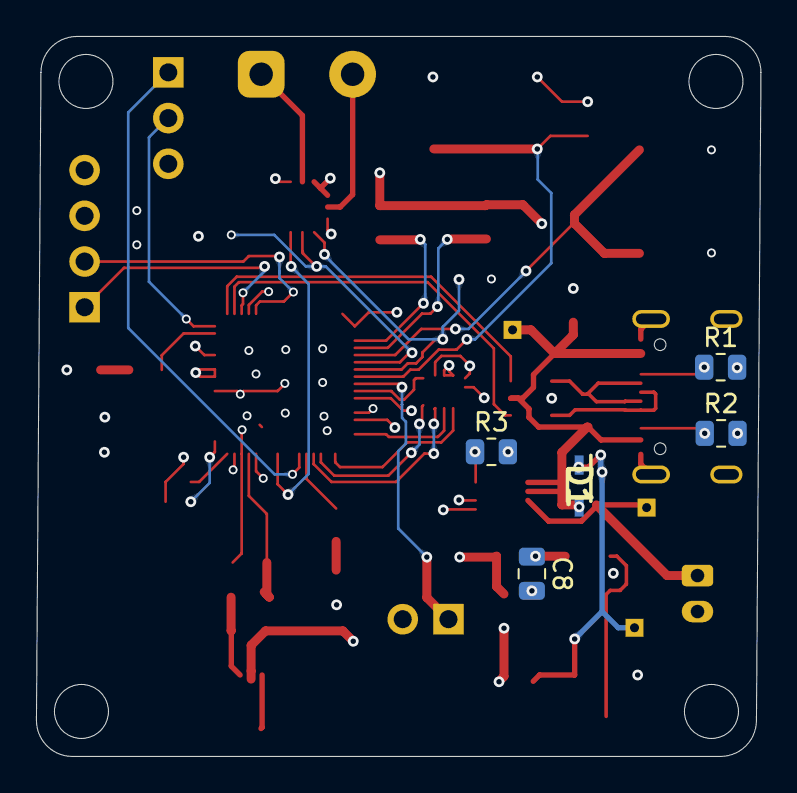
[picture p10: board wearable_som.kicad_pcb from below]

Board: 4 copper layers, 40.2 x 40.0 mm, 48 parts (5 on the bottom side), 44 nets.

Other parts of the board:
C9: 0.1uF; C_0805_2012Metric

Their connections:
+3.3V: C9.1; also elsewhere on the board
GND: C9.2; also elsewhere on the board
