ray4477/Senior-design-fit-ml/wearable_v1_sw/wearable_v1_sw.ioc

Mcu.UserName=STM32WB55RGVx
PA1.Signal=SPI1_SCK
PA10.Signal=USART1_RX
PA11.Signal=USB_DM
PA12.Signal=USB_DP
PA13.Signal=SYS_JTMS-SWDIO
PA14.Signal=SYS_JTCK-SWCLK
PA4.Signal=SPI1_NSS
PA5.Signal=GPIO_Output
PA6.Signal=SPI1_MISO
PA7.Signal=SPI1_MOSI
PA8.Signal=GPIO_Output
PA9.Signal=USART1_TX
PB0.Signal=GPIO_Output
PB1.Signal=GPIO_Output
PB10.Signal=I2C3_SCL
PB11.Signal=I2C3_SDA
PB13.Signal=GPIO_Input
PB8.Signal=I2C1_SCL
PB9.Signal=I2C1_SDA
PC0.Signal=ADCx_IN1
PC1.Signal=GPIO_Input
PC14-OSC32_IN.Signal=RCC_OSC32_IN
PC15-OSC32_OUT.Signal=RCC_OSC32_OUT
PC2.Signal=GPIO_Input
