ray4477/Senior-design-fit-ml/custom_nrf_firmware/src/imu_driver.c

/*
 * Copyright (c) 2021 Bosch Sensortec GmbH
 *
 * SPDX-License-Identifier: Apache-2.0
 */

 #include <zephyr/kernel.h>
 #include <zephyr/device.h>
 #include <zephyr/drivers/sensor.h>
 #include <stdio.h>
 static const struct device *const dev = DEVICE_DT_GET_ONE(bosch_bmi270);


int get_imu_data(struct sensor_value *acc, struct sensor_value *gyr) {
    /* 10ms period, 100Hz Sampling frequency */
    // k_sleep(K_MSEC(10));

    if(sensor_sample_fetch(dev)) {
      //failed to fetch data
      return -1;

    } else {
    }

    if(sensor_channel_get(dev, SENSOR_CHAN_ACCEL_XYZ, acc)) {
      return -1;
    }
    
    if(sensor_channel_get(dev, SENSOR_CHAN_GYRO_XYZ, gyr)) {
      return -1;
    }

    return 0;
}

 int bmi_init(void)
 {

   struct sensor_value acc[3], gyr[3];
   struct sensor_value full_scale, sampling_freq, oversampling;
 
   if (!device_is_ready(dev)) {
     return 0;
   }
 
   printf("Device %p name is %s\n", dev, dev->name);
 
   /* Setting scale in G, due to loss of precision if the SI unit m/s^2
    * is used
    */
   full_scale.val1 = 2;            /* G */
   full_scale.val2 = 0;
   sampling_freq.val1 = 100;       /* Hz. Performance mode */
   sampling_freq.val2 = 0;
   oversampling.val1 = 1;          /* Normal mode */
   oversampling.val2 = 0;
 
   sensor_attr_set(dev, SENSOR_CHAN_ACCEL_XYZ, SENSOR_ATTR_FULL_SCALE,
       &full_scale);
   sensor_attr_set(dev, SENSOR_CHAN_ACCEL_XYZ, SENSOR_ATTR_OVERSAMPLING,
       &oversampling);
   /* Set sampling frequency last as this also sets the appropriate
    * power mode. If already sampling, change to 0.0Hz before changing
    * other attributes
    */
   sensor_attr_set(dev, SENSOR_CHAN_ACCEL_XYZ,
       SENSOR_ATTR_SAMPLING_FREQUENCY,
       &sampling_freq);
 
 
   /* Setting scale in degrees/s to match the sensor scale */
   full_scale.val1 = 500;          /* dps */
   full_scale.val2 = 0;
   sampling_freq.val1 = 100;       /* Hz. Performance mode */
   sampling_freq.val2 = 0;
   oversampling.val1 = 1;          /* Normal mode */
   oversampling.val2 = 0;
 
   sensor_attr_set(dev, SENSOR_CHAN_GYRO_XYZ, SENSOR_ATTR_FULL_SCALE,
       &full_scale);
   sensor_attr_set(dev, SENSOR_CHAN_GYRO_XYZ, SENSOR_ATTR_OVERSAMPLING,
       &oversampling);
   /* Set sampling frequency last as this also sets the appropriate
    * power mode. If already sampling, change sampling frequency to
    * 0.0Hz before changing other attributes
    */
   sensor_attr_set(dev, SENSOR_CHAN_GYRO_XYZ,
       SENSOR_ATTR_SAMPLING_FREQUENCY,
       &sampling_freq);

   return 0;
 }
