ray4477/Senior-design-fit-ml/custom_nrf_firmware/src/main.h

#include "imu_service.h"


#define DEVICE_NAME CONFIG_BT_DEVICE_NAME
#define DEVICE_NAME_LEN (sizeof(DEVICE_NAME) - 1)

#define RUN_STATUS_LED DK_LED1
#define CON_STATUS_LED DK_LED2
#define USER_LED DK_LED3
#define USER_BUTTON DK_BTN1_MSK

#define STACKSIZE 1024
#define PRIORITY 7

#define RUN_LED_BLINK_INTERVAL 1000
/* STEP 17 - Define the interval at which you want to send data at */
#define NOTIFY_INTERVAL 500

static const struct bt_le_adv_param *adv_param = BT_LE_ADV_PARAM(
	(BT_LE_ADV_OPT_CONNECTABLE |
	 BT_LE_ADV_OPT_USE_IDENTITY), /* Connectable advertising and use identity address */
	32, /* Min Advertising Interval 500ms (800*0.625ms) */
	80, /* Max Advertising Interval 500.625ms (801*0.625ms) */
	NULL); /* Set to NULL for undirected advertising */

static const struct bt_data ad[] = {
  BT_DATA_BYTES(BT_DATA_FLAGS, (BT_LE_AD_GENERAL | BT_LE_AD_NO_BREDR)),
  BT_DATA(BT_DATA_NAME_COMPLETE, DEVICE_NAME, DEVICE_NAME_LEN),

};

static const struct bt_data sd[] = {
	BT_DATA_BYTES(BT_DATA_UUID128_ALL, BT_UUID_IMU_SERVICE_VAL),
};

void set_led(bool led_state);
