ray4477/Senior-design-fit-ml/(commit log)

2024-11-08 ioc, schematic started
    [wearable_som.kicad_pcb, wearable_som.kicad_sch]
2024-11-09 done with power circuitry
    uses mcp73831 and ldo for lipo charging
    (^._.^)ﾉ😜
    [wearable_som.kicad_sch]
2024-11-10 added imu, rf circuitry📡😹
    💃
    [wearable_som.kicad_sch]
2024-11-11 💃added d-,d+ protection, swd, todo statements
    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
    [wearable_som.kicad_sch]
2024-11-11 stuff🤓
    [wearable_som.kicad_sch]
2024-11-18 add haptic feedback
    [wearable_som.kicad_sch]
2024-11-20 pcb layout almost done
    [wearable_som.kicad_pcb, wearable_som.kicad_sch]
2024-11-20 init layout done
    [wearable_som.kicad_pcb]
2024-11-21 layout done v1 - needs rework
    [wearable_som.kicad_pcb]
2024-11-23 revisions revisions
    2->4 layers
    improved ground plane + ic placement
    added adc for force sensor
    [wearable_som.kicad_pcb, wearable_som.kicad_sch]
2024-11-24 fix drc errors
    [wearable_som.kicad_pcb]
2024-11-25 final v1 layout done
    [bom.csv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]
2025-01-29 wearables v2
    [bom.csv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]
2025-02-10 new nrf variant
    [wearable_v2_nrf.kicad_pcb, wearable_v2_nrf.kicad_sch, wearables_v2.kicad_pcb, wearables_v2.kicad_sch]
2025-03-03 finished nrf schematic/layout 👷‍♂️
    [wearable_v2_nrf.kicad_pcb, wearables_v2.kicad_pcb, wearables_v2.kicad_sch]
2025-03-03 forgot to push schematic
    [wearable_v2_nrf.kicad_sch]
2025-03-17 changes
    fixed mosfet symbol-footprint,
    connection jst->molex pico,
    made HSC closer
    [bom.csv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]
2025-03-31 v2 revisions for nrf pcb
    fix imu, fix adc
    includes new firmware for nrf52811
    [wearable_v2_nrf-B_Cu.gbr, wearable_v2_nrf-B_Mask.gbr, wearable_v2_nrf-B_Paste.gbr, wearable_v2_nrf-B_Silkscreen.gbr, wearable_v2_nrf-Edge_Cuts.gbr, wearable_v2_nrf-F_Cu.gbr, wearable_v2_nrf-F_Mask.gbr, wearable_v2_nrf-F_Paste.gbr]
2025-03-31 final nrf board edits + ble sniffer py script
    [wearable_v2_nrf.kicad_pcb, wearable_v2_nrf.kicad_sch]
2025-04-01 final pcb design :)
    [wearable_v2_nrf-B_Cu.gbr, wearable_v2_nrf-B_Mask.gbr, wearable_v2_nrf-B_Paste.gbr, wearable_v2_nrf-B_Silkscreen.gbr, wearable_v2_nrf-Edge_Cuts.gbr, wearable_v2_nrf-F_Cu.gbr, wearable_v2_nrf-F_Mask.gbr, wearable_v2_nrf-F_Paste.gbr]
2025-04-21 new enclosure, wip
    [v2_enclosure.stl, wearable_enclosure.stl, wearable_v2_nrf.kicad_pcb]
2026-10-25 add odb++ files from kicad
