ray4477/Senior-design-fit-ml/(notices)

Notices in the files:
wearable_v1_sw/Core/Inc/app_conf.h:
Copyright (c) 2024 STMicroelectronics.
All rights reserved.
This software is licensed under terms that can be found in the LICENSE file
